smunaut/ttsky-mini-mosbius/README.md

 

# tnt's take on Mini-MOSbius for SKY130 TT shuttles

- [Read the documentation for project](docs/info.md)
