smunaut/ttsky-mini-mosbius/(commit log)

2025-09-01 xschem: Initial import from Andrew Kang's repo
    This is imported schematics/testbenches from Andrew Kang's repo
    as of Aug 20th 205.
    From commit 84f8491aceb4d83e49300a08714a340068331fde
    [dff.sch, diff_n.sch, diff_p.sch, mirror_n.sch, mirror_p.sch, mosbius.sch, nmos_prog.sch, ota_n.sch]
2025-09-01 xschem: Remove non-needed file
    The top level and control will be handled in verilog, so
    remove anything related to that along with some files that
    seem useless.
    [dff.sch, shift_reg.sch, shift_reg_short.sch, tb_shift_reg.sch, tb_temp.sch, top_mosbius.sch, tt_asw_3v3_backup.sch]
2025-09-01 xschem: Adapt cut nf by 1/3 for PMOS
    In the original design, PMOS were 3 times larger by using 3 times more
    fingers than for NMOS. However for layout it's not always practical,
    so instead I multiplied the per finger width by 1.5 ( making it 7.5um )
    and then multiplied the number of finger by 2. Result is PMOS are still
    3 times bigger but the aspect ratio isn't as skewed.
    [diff_p.sch, mirror_p.sch, ota_n.sch, pmos_prog.sch, tb_mosbius_ota2stage_stab.sch, tb_mosbius_ringo.sch, tb_pmos_prog.sch]
2025-09-01 xschem: Import design changes
    It would have been better split in several commits, but that was
    hard to do since so many little things need to change at onces ...
    Design changes are :
    - bus_A / bus_B are exported as pins so the top level can choose
    what to wire to external pins
    - Only some busses can be tied to VGND/VAPWR to save on switches
    - The second output from the OTA can be wired out
    - Transistors bulk are wired to supply rail rather than their source
    (Deep-N-Well are _very_ space intensive)
    - The OTA config between diode load and current mirror load is done
    using two different config bits rather than using a local inverter.
    All test benches were updated appropriately a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
    [diff_n.sch, diff_p.sch, mirror_p.sch, mosbius.sch, nmos_prog.sch, ota_n.sch, pmos_prog.sch, tb_mosbius_dpn_ac.sch]
2025-09-01 src: Import actual sources
    Note the build doesn't work yet since it depends on generating
    "decap" files for the control blocks that are generated with
    layout scripts that will be imported later.
    [ctrl_block.v, ctrl_top.v, stdcells.v]
